cybdarren/HalloweenFate/(commit log)

2021-07-01 Changed sense of motion detect to logic HIGH. Added short delay when starting movie playing
    [HalloweenFate.pde]
2021-07-02 Added holdoff delay and tuned for pico projector output
2021-07-02 Reversed servo operation to match physical box
    [HalloweenFate.pde]
