cybdarren/HalloweenFate/images/IMG_4220.jpg

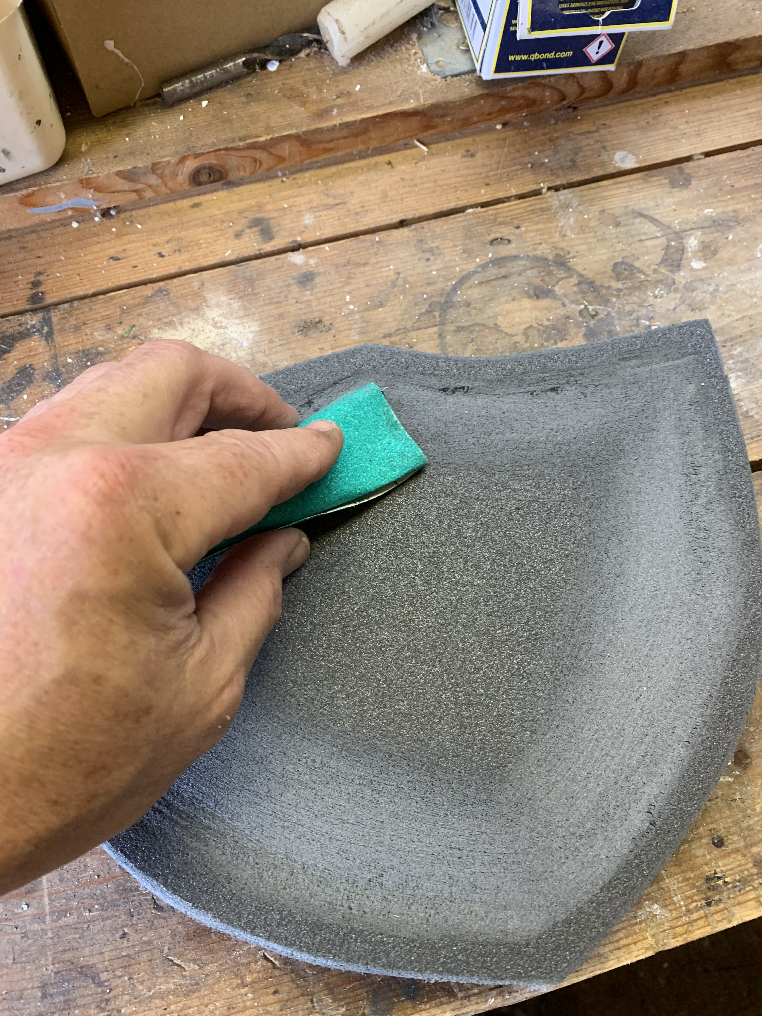
images/IMG_4220.jpg
