cybdarren/HalloweenFate/images/IMG_4310.jpg

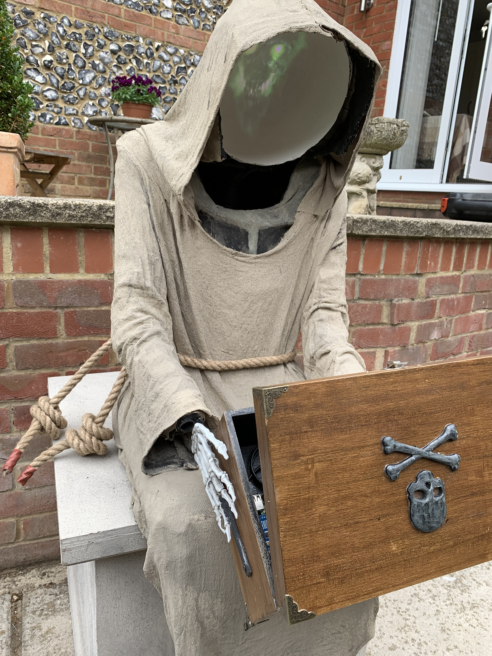
[picture p1: images/IMG_4310.jpg]
images/IMG_4310.jpg
