cybdarren/HalloweenFate/images/IMG_4308.jpg

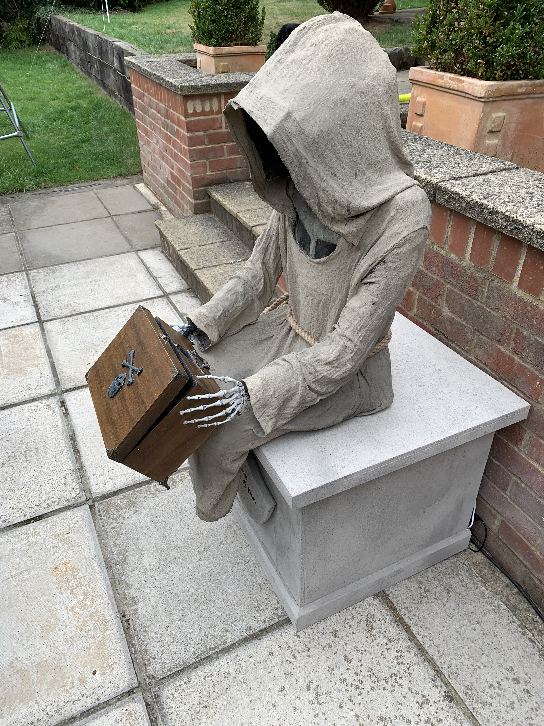
[picture p2: images/IMG_4308.jpg]
images/IMG_4308.jpg
