cybdarren/HalloweenFate/images/IMG_4254.jpg

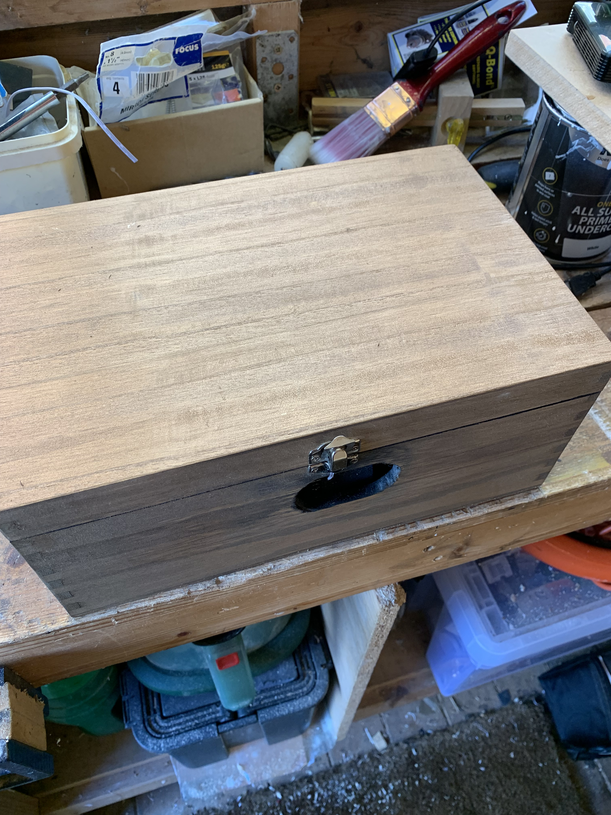
[picture p5: images/IMG_4254.jpg]
images/IMG_4254.jpg
