cybdarren/HalloweenFate/images/IMG_4257.jpg

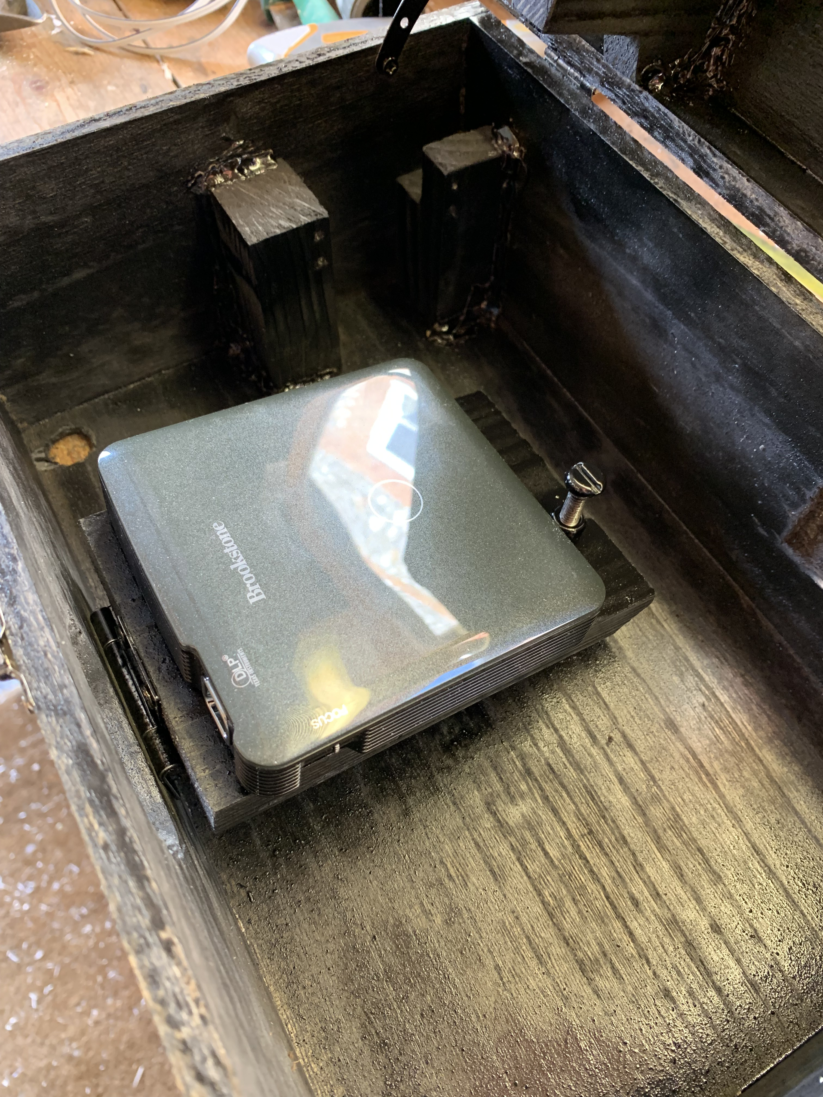
[picture p7: images/IMG_4257.jpg]
images/IMG_4257.jpg
