cybdarren/HalloweenFate/images/IMG_4261.jpg

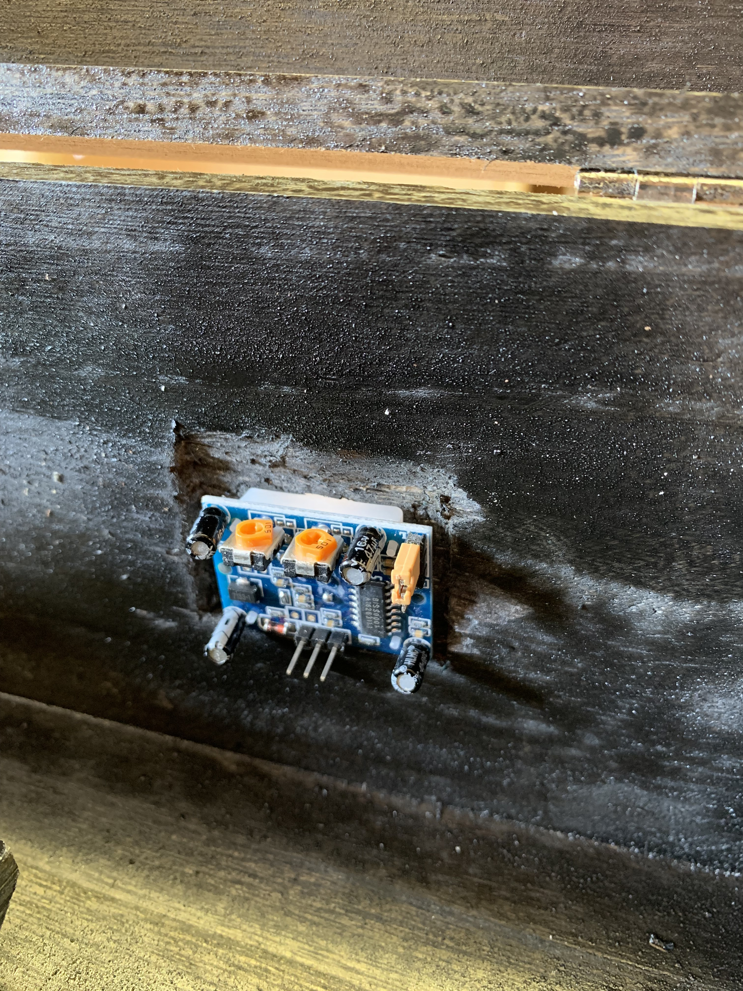
[picture p8: images/IMG_4261.jpg]
images/IMG_4261.jpg
