cybdarren/HalloweenFate/images/IMG_4259.jpg

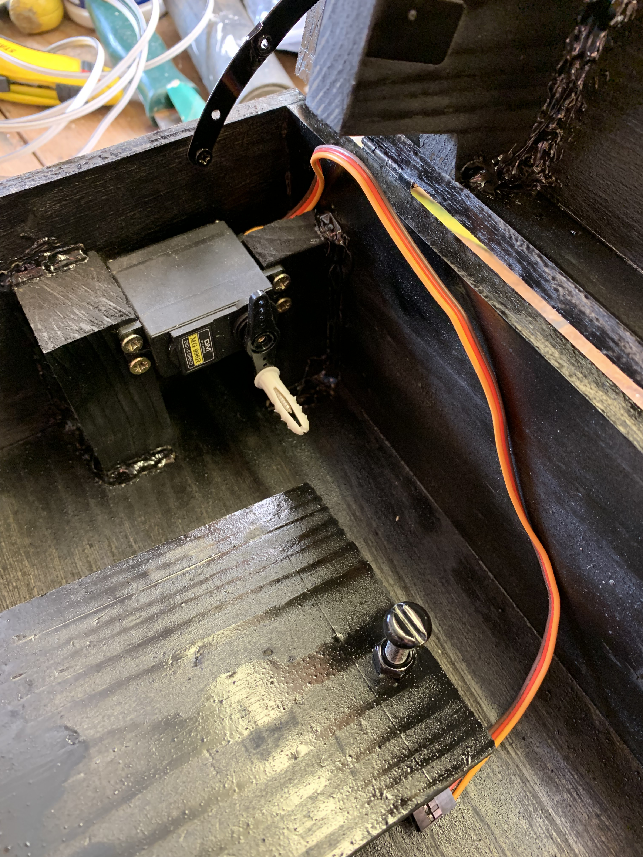
[picture p9: images/IMG_4259.jpg]
images/IMG_4259.jpg
