cybdarren/HalloweenFate/images/IMG_4291.jpg

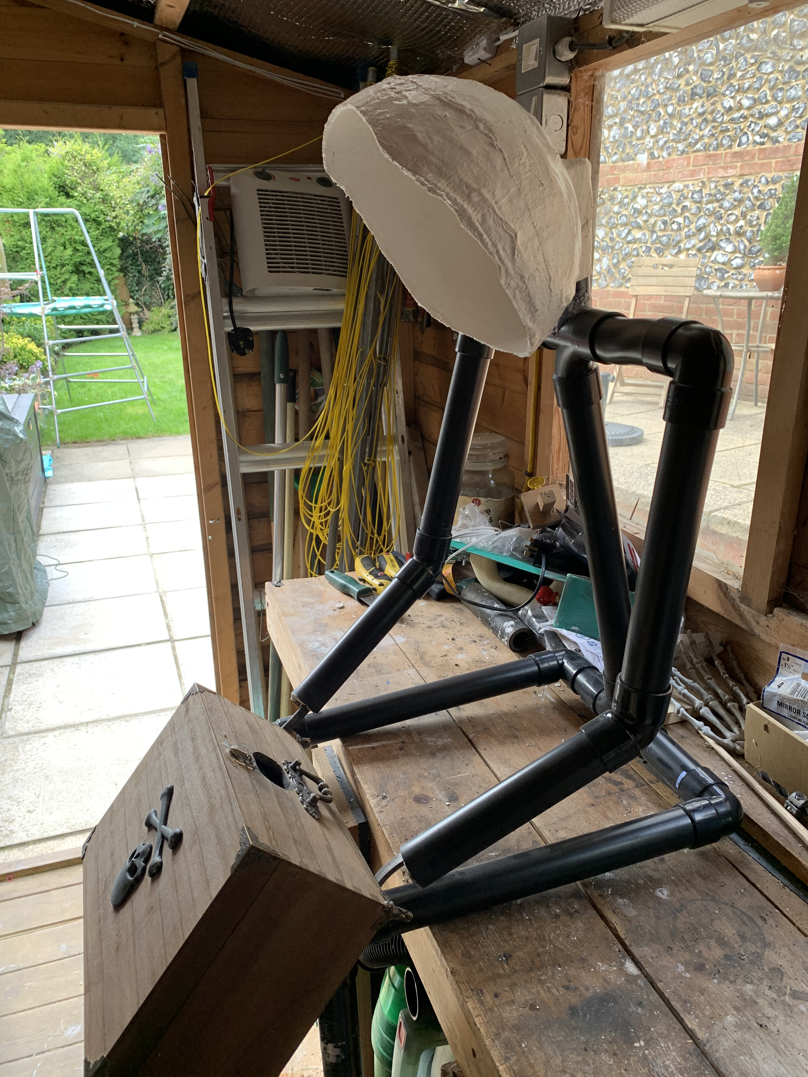
[picture p10: images/IMG_4291.jpg]
images/IMG_4291.jpg
