cybdarren/HalloweenFate/images/IMG_4297.jpg

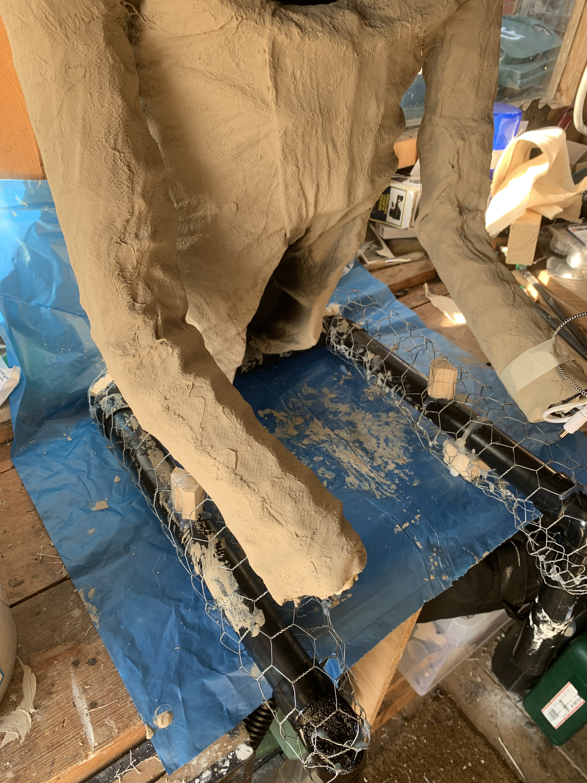
[picture p11: images/IMG_4297.jpg]
images/IMG_4297.jpg
